GabrielBojaca/AeroBalancin/platformio/src/grafica_HINF.png

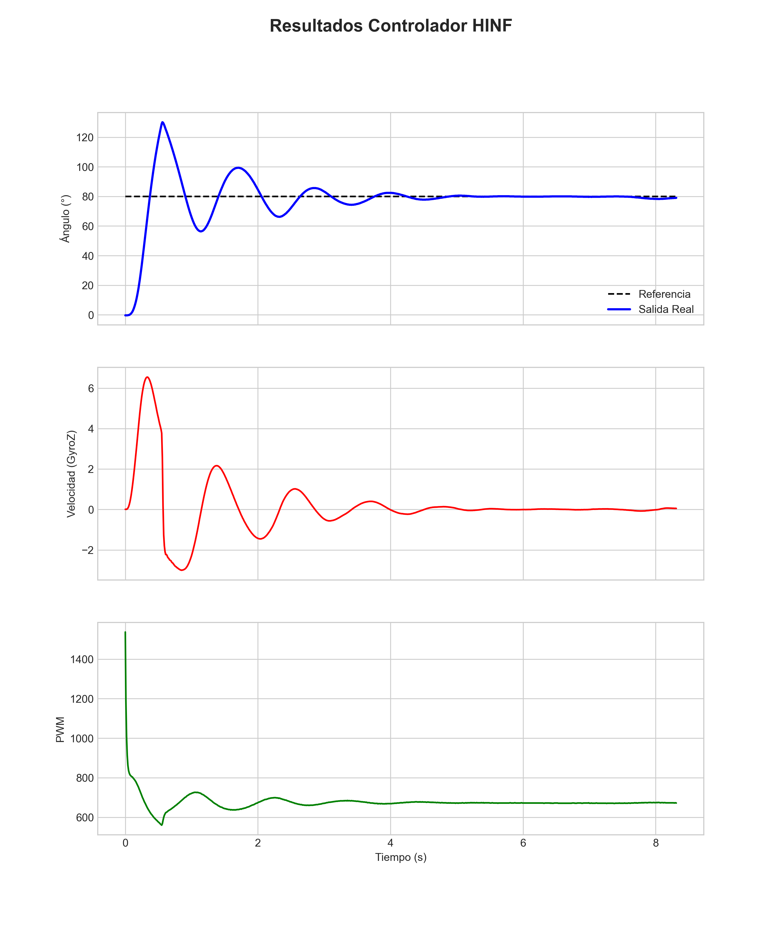
platformio/src/grafica_HINF.png
