GabrielBojaca/AeroBalancin/platformio/src/grafica_MRAC.png

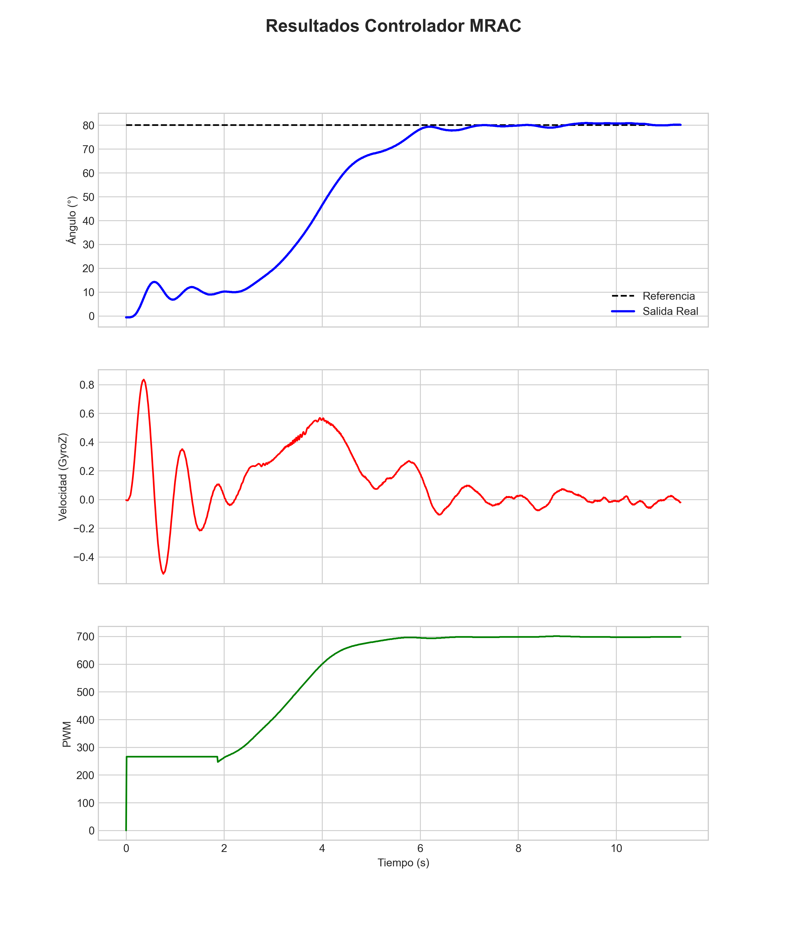
platformio/src/grafica_MRAC.png
