GabrielBojaca/AeroBalancin/platformio/src/grafica_PI_slow.png

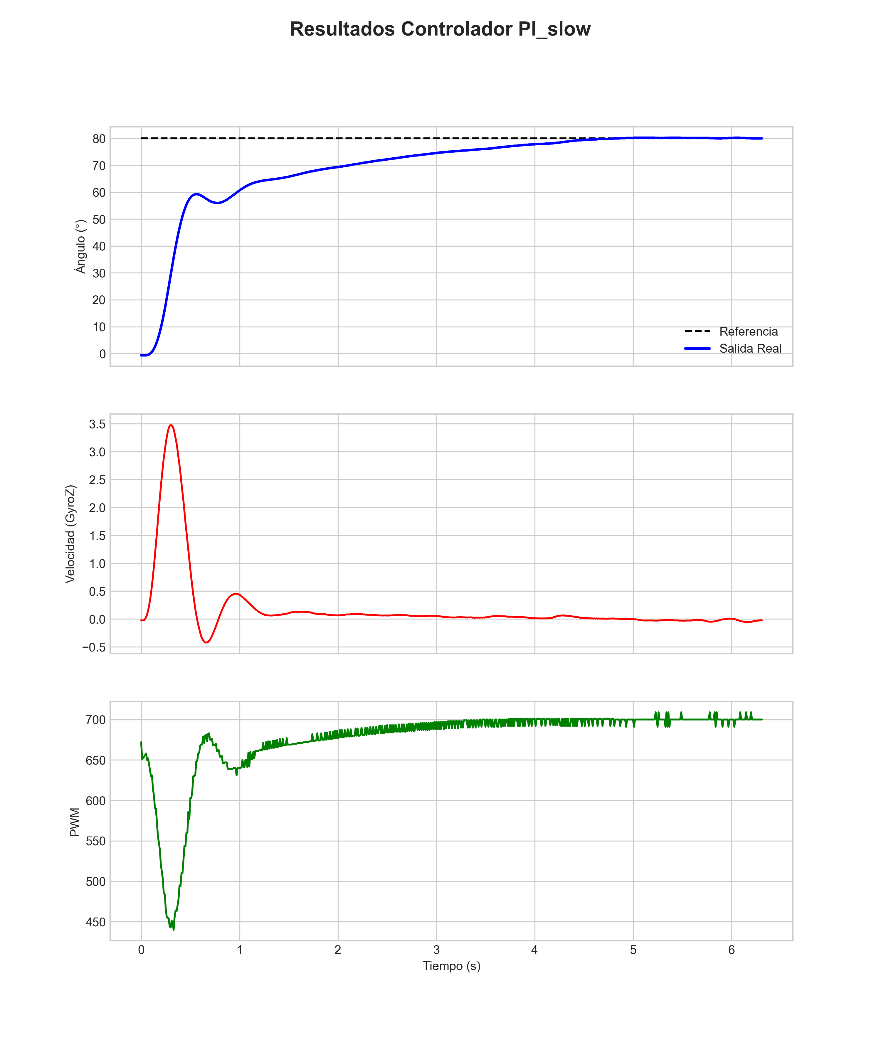
platformio/src/grafica_PI_slow.png
