GabrielBojaca/AeroBalancin/platformio/src/grafica_SMC.png

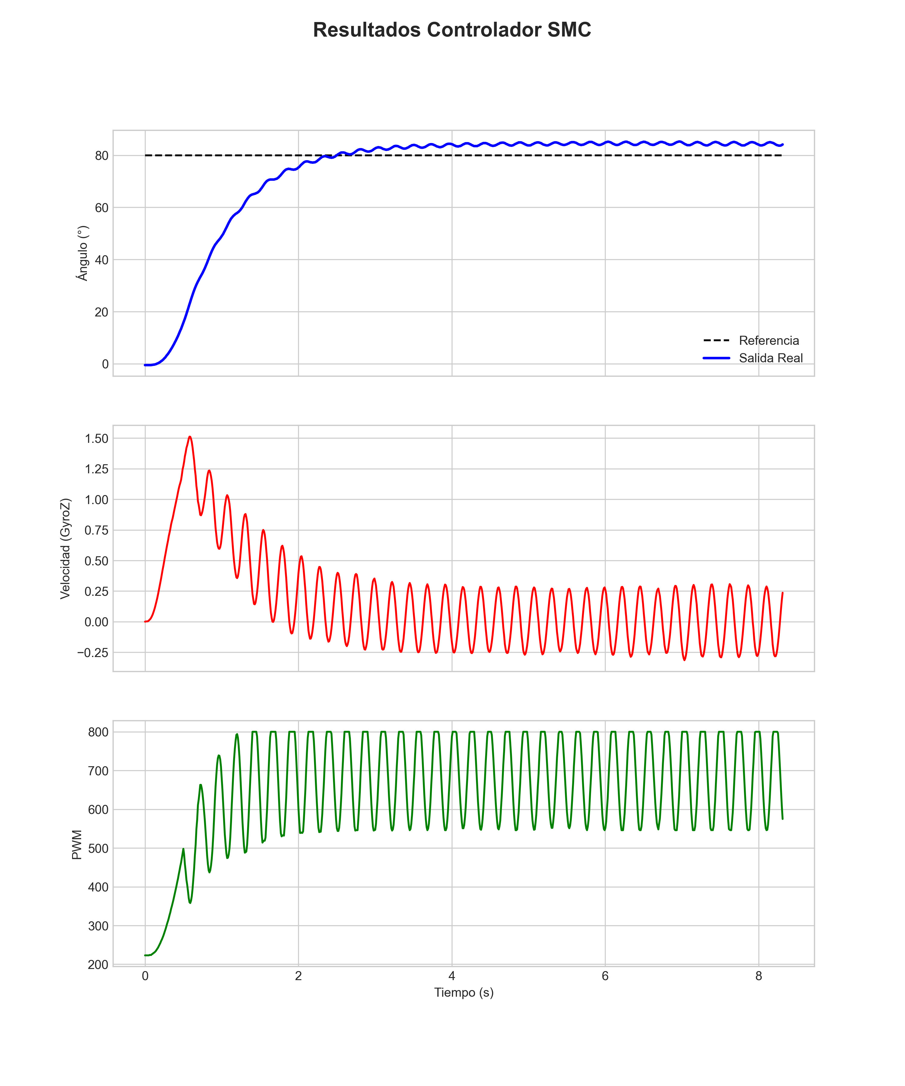
platformio/src/grafica_SMC.png
