GabrielBojaca/AeroBalancin/Modelo-CAD/cw_2blades.stl

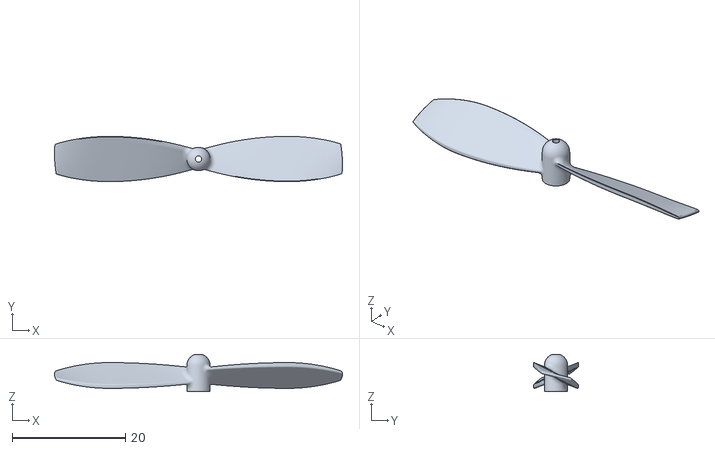
[picture p5: CAD file, 2025-11-11]
Modelo-CAD/cw_2blades.stl
50.9 x 8.00 x 6.59
