GabrielBojaca/AeroBalancin/Modelo-CAD/PROPELLER - 8x4.5 CW.STEP

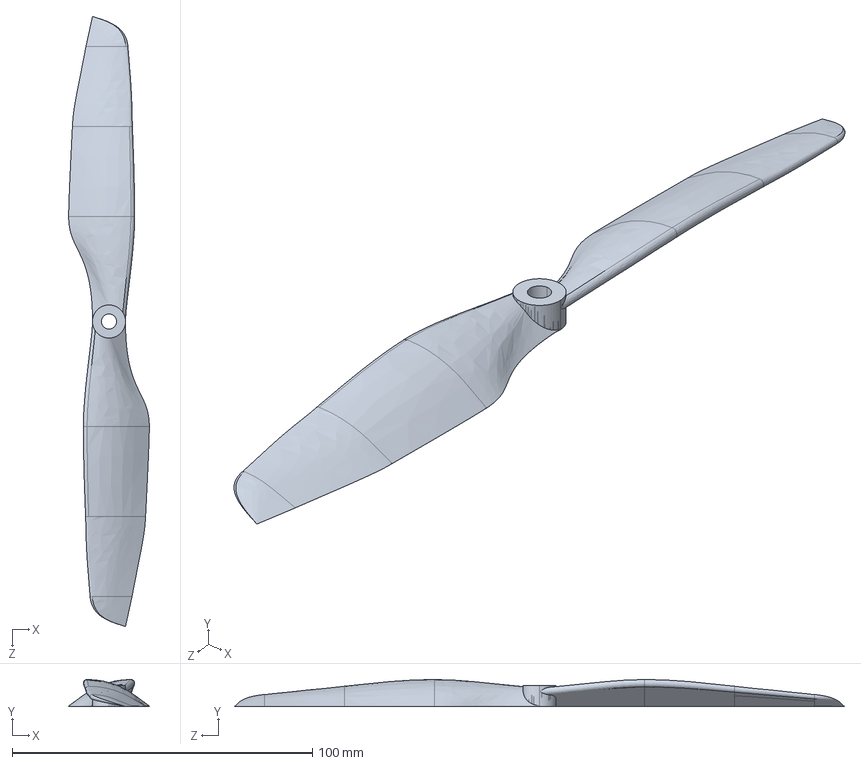
[picture p6: CAD file, 2025-11-11]
Modelo-CAD/PROPELLER - 8x4.5 CW.STEP
26.9 x 9.01 x 203.2 mm
