GabrielBojaca/AeroBalancin/Modelo-CAD/MPU_6050.step

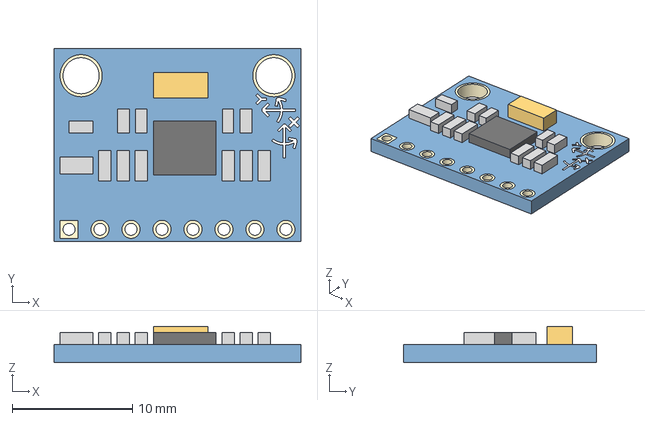
[picture p7: CAD file, 2025-11-11]
Modelo-CAD/MPU_6050.step
20.5 x 16.0 x 3.00 mm
