GabrielBojaca/AeroBalancin/Modelo-CAD/Coreless_Motor_716.step

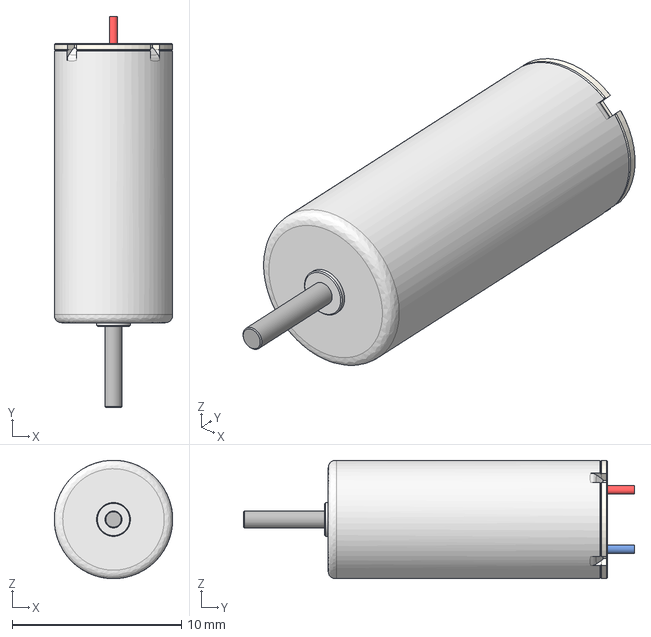
[picture p8: CAD file, 2025-11-11]
Modelo-CAD/Coreless_Motor_716.step
7.00 x 23.1 x 7.00 mm
