GabrielBojaca/AeroBalancin/Modelo-CAD/AS5600_magnetic_encoder.step

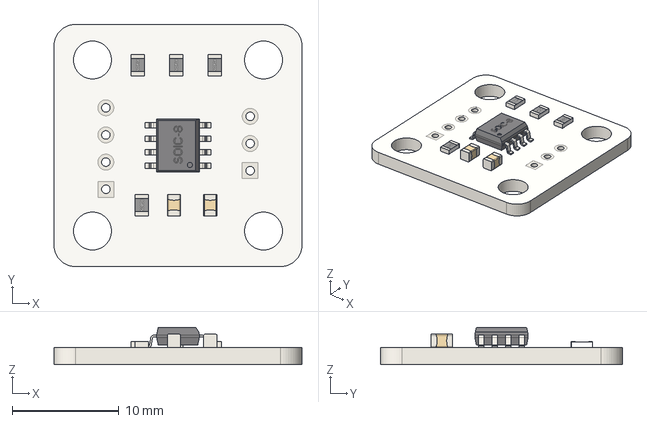
[picture p9: CAD file, 2025-11-11]
Modelo-CAD/AS5600_magnetic_encoder.step
23.2 x 22.6 x 3.50 mm
