GabrielBojaca/AeroBalancin/(list of files, cad)

Other CAD files:
Modelo-CAD/Ensamblaje.dwg
Modelo-CAD/Analisis_Pendulo.dwg
Modelo-CAD/OldVersions/Ensamblaje.0003.dwg
Modelo-CAD/OldVersions/Analisis_Pendulo.0002.dwg
Modelo-CAD/04 Drone propeller/04 Drone propeller/04 Drone propeller.ipt
Modelo-CAD/AS5600_magnetic_encoder/AS5600_magnetic_encoder/AS5600_magnetic_encoder.ipt
Modelo-CAD/AS5600_magnetic_encoder/AS5600_magnetic_encoder/OldVersions/AS5600_magnetic_encoder.0001.ipt
Modelo-CAD/Acople_eje.ipt
Modelo-CAD/Arandela_1_8.ipt
Modelo-CAD/Arandela_3_16.ipt
Modelo-CAD/Base.ipt
Modelo-CAD/Chumacera.ipt
Modelo-CAD/Columna.ipt
Modelo-CAD/Contrapeso.iam
Modelo-CAD/Coreless_Motor_716/Coreless_Motor_716/Coreless_Motor_716.ipt
Modelo-CAD/Coreless_Motor_716/Coreless_Motor_716/OldVersions/Coreless_Motor_716.0004.ipt
Modelo-CAD/Ensamblaje.iam
Modelo-CAD/Ensamblaje.ipn
Modelo-CAD/Escuadra.ipt
Modelo-CAD/MPU_6050/MPU_6050/MPU_6050.ipt
Modelo-CAD/MPU_6050/MPU_6050/OldVersions/MPU_6050.0001.ipt
Modelo-CAD/MR126ZZ-6x12x4mm.ipt
Modelo-CAD/OldVersions/Acople_eje.0002.ipt
Modelo-CAD/OldVersions/Arandela_1_8.0001.ipt
Modelo-CAD/OldVersions/Arandela_3_16.0001.ipt
Modelo-CAD/OldVersions/Base.0002.ipt
Modelo-CAD/OldVersions/Chumacera.0003.ipt
Modelo-CAD/OldVersions/Columna.0004.ipt
Modelo-CAD/OldVersions/Contrapeso.0001.iam
Modelo-CAD/OldVersions/Ensamblaje.0011.iam
Modelo-CAD/OldVersions/Ensamblaje.0012.ipn
Modelo-CAD/OldVersions/Escuadra.0002.ipt
Modelo-CAD/OldVersions/MR126ZZ-6x12x4mm.0001.ipt
Modelo-CAD/OldVersions/Pendulo.0002.ipt
Modelo-CAD/OldVersions/Separador.0003.ipt
Modelo-CAD/OldVersions/Sollo_Brazo_centro_gravedad.0001.iam
Modelo-CAD/OldVersions/Solo_Brazo.0002.iam
Modelo-CAD/OldVersions/Tope_rodamiento.0003.ipt
Modelo-CAD/OldVersions/Tuerca_M3.0001.ipt
Modelo-CAD/OldVersions/eje.0001.ipt
Modelo-CAD/PROPELLER - 8x4.5 CW/OldVersions/cw_2blades.0001.ipt
Modelo-CAD/PROPELLER - 8x4.5 CW/cw_2blades.ipt
Modelo-CAD/Patas_para_licuadora.ipt
Modelo-CAD/Pendulo.ipt
Modelo-CAD/Separador.ipt
Modelo-CAD/Sollo_Brazo_centro_gravedad.iam
Modelo-CAD/Solo_Brazo.iam
Modelo-CAD/Tope_rodamiento.ipt
Modelo-CAD/Tuerca_M3.ipt
Modelo-CAD/eje.ipt
Modelo-CAD/iman.ipt
