GabrielBojaca/AeroBalancin/Modelo-CAD/PDF/Analisis_Pendulo.pdf

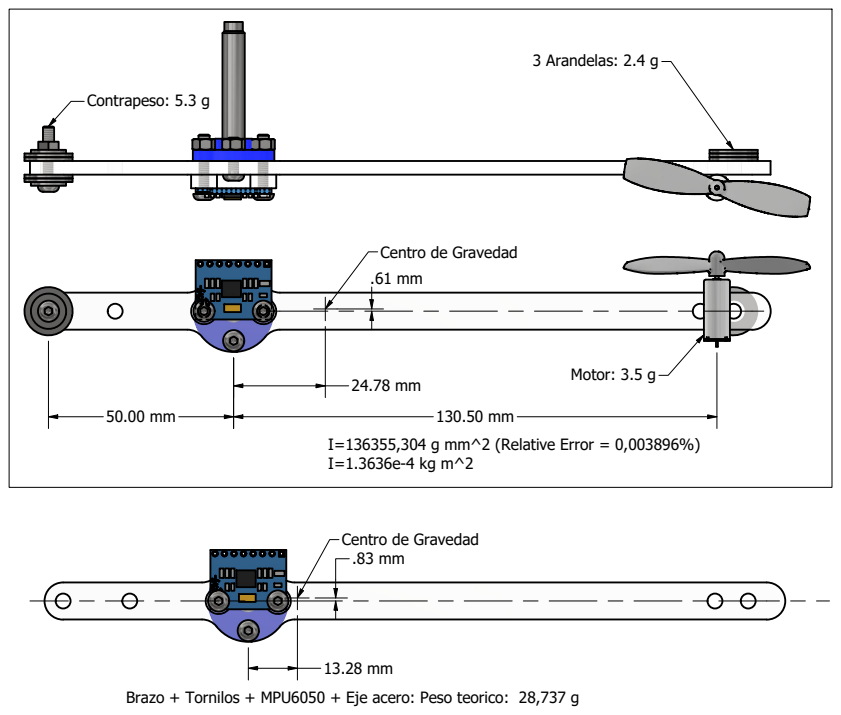
[picture p10: page 1]
3 Arandelas: 2.4 g; Motor: 3.5 g; Contrapeso: 5.3 g

Centro de Gravedad

I=136355,304 g mm^2 (Relative Error = 0,003896%)

Brazo + Tornilos + MPU6050 + Eje acero: Peso teorico: 28,737 g
