GabrielBojaca/AeroBalancin/Modelo-CAD/PDF/Ensamblaje.pdf

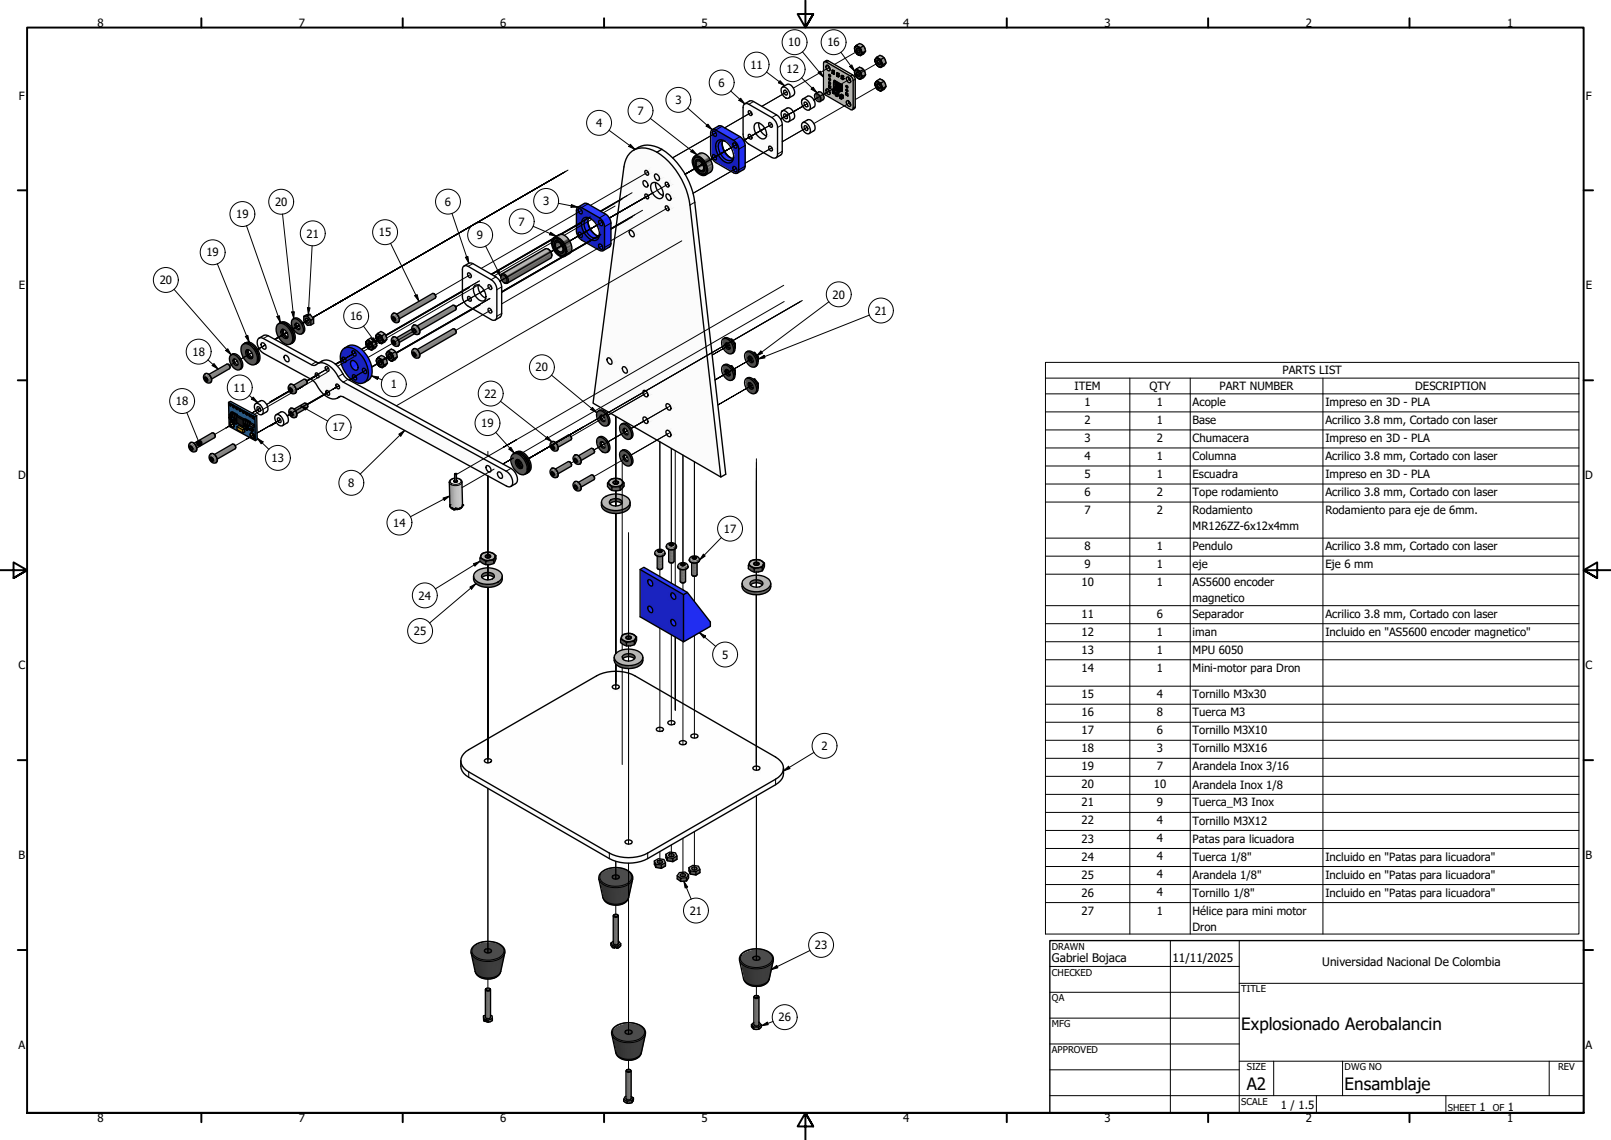
[picture p11: page 1]
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

1 5 | 4 | T o r n illo M 3 x 3 0
1 6 | 8 | T u e r c a M 3
1 7 | 6 | T o r n illo M 3 X 1 0
1 8 | 3 | T o r n illo M 3 X 1 6
1 9 | 7 | A r a n d ela I n o x 3 / 1 6
2 0 | 1 0 | A r a n d ela I n o x 1 / 8
2 1 | 9 | T u e r c a _ M 3 I n o x
2 2 | 4 | T o r n illo M 3 X 1 2
2 3 | 4 | P a t a s p a r a li c u a d o r a
2 4 | 4 | T u e r c a 1 / 8 " | I n clu i d o e n " P a t a s p a r a li c u a d o r a "
2 5 | 4 | A r a n d ela 1 / 8 " | I n clu i d o e n " P a t a s p a r a li c u a d o r a "
2 6 | 4 | T o r n illo 1 / 8 " | I n clu i d o e n " P a t a s p a r a li c u a d o r a "
2 7 | 1 | éli H c e p a r a m i n i m o t o r D r o n

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

S I Z E A 2 | D W G N O E n s a m bla j e | R E V
