GabrielBojaca/AeroBalancin/(commit log)

2025-11-11 Commit inicial
    [04 Drone propeller.ipt, AS5600_magnetic_encoder.0001.ipt, AS5600_magnetic_encoder.ipt, AS5600_magnetic_encoder.step, Acople_eje.0002.ipt, Acople_eje.ipt, Analisis_Pendulo.0002.dwg, Analisis_Pendulo.dwg]
2025-11-26 Implementación PID en main.cpp
2025-11-27 Implementación IMU - Bug Temporal
    [main.cpp]
2025-11-27 Corrección bug temporal implementando INPUT_PULLUP
    [main.cpp]
2025-11-27 Implementación tiempo de muestreo con micros
2025-11-30 Actualización relación PWM-Fm, implementación PI lento para caracterización rapida
2025-11-30 Bandera para debug, actualizacion H_inf
2025-11-30 Implementación rutina de aproximacion y script de graficación
2025-12-01 Aproximacion con PID
2025-12-01 Correción rutina de aproximación | Cambios en clase
2025-12-02 Add files via upload
    smc falta revisar si el resto quedo bien
2025-12-09 MRAC y graficas
    [datos_HINF.csv, datos_MRAC.csv, datos_PI_slow.csv, datos_SMC.csv]
2025-12-10 Introduccion preliminar sintonización PID
2025-12-10 Correccion del pico de arranque PI_D, filtro a la derivada
